Daniela-MC/MALUDA/Captura1.JPG

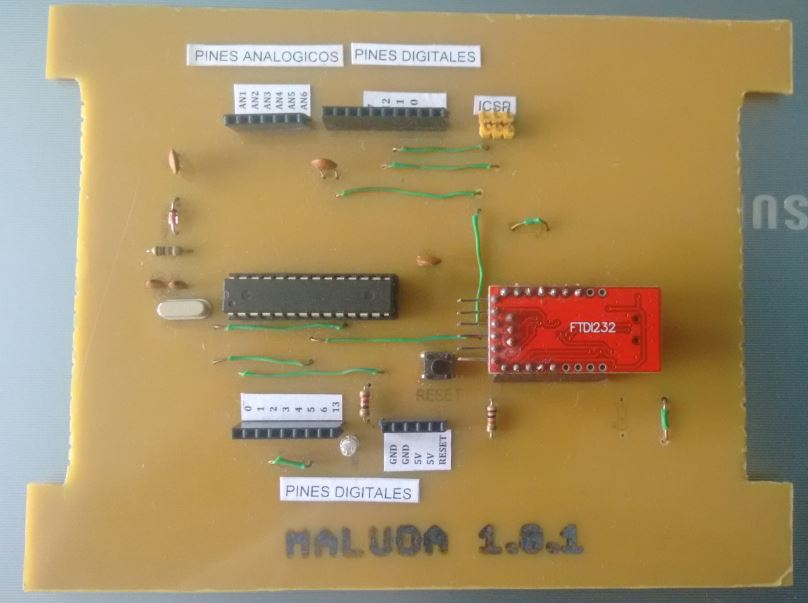
Captura1.JPG
