Daniela-MC/MALUDA/IMG_20170220_080314507.jpg

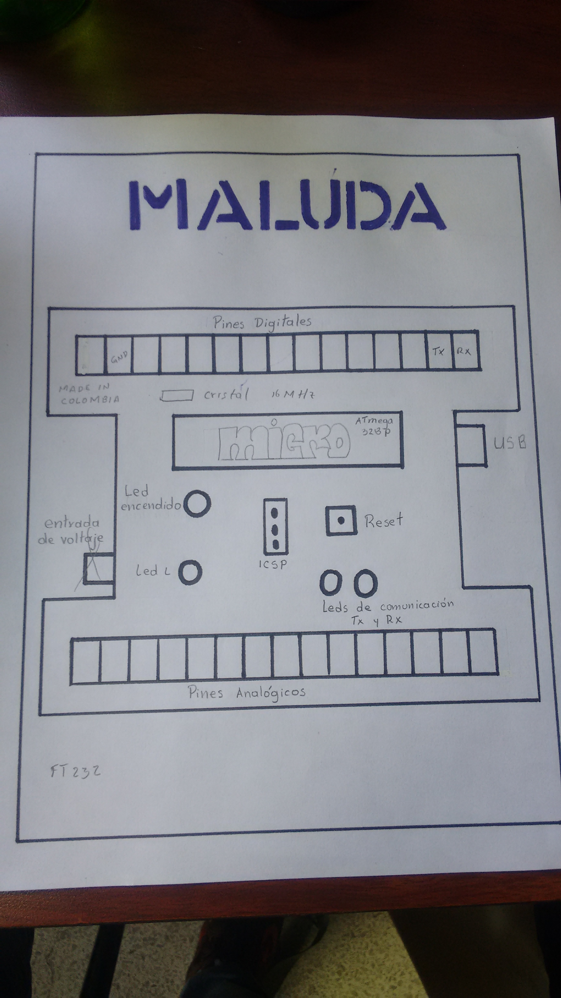
IMG_20170220_080314507.jpg
