Daniela-MC/MALUDA/PCB/PCB.sch

## EAGLE design PCB/PCB.sch (2017-03-07)

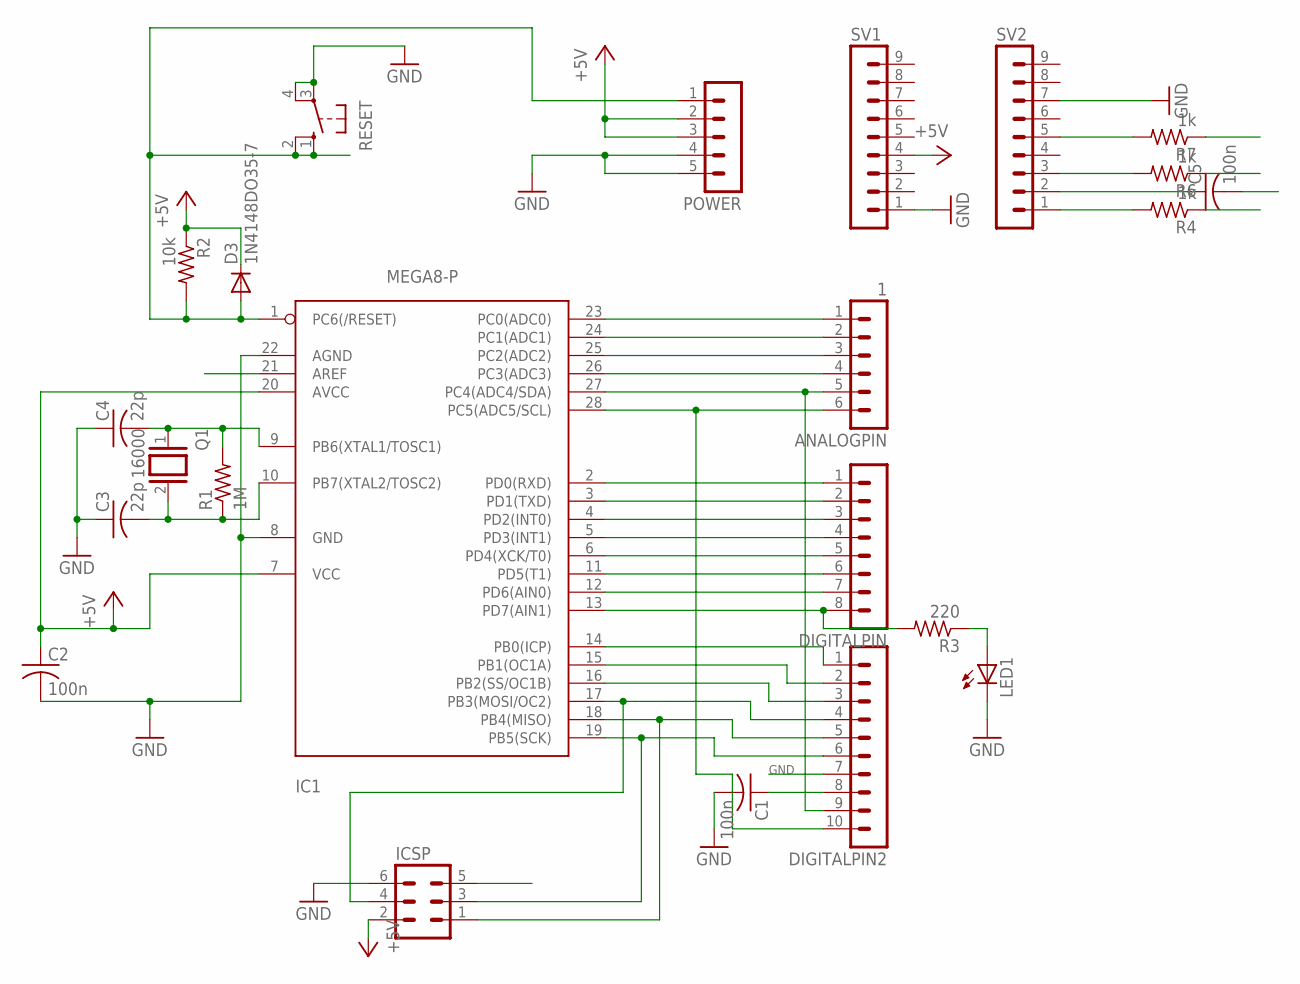
[picture p15: schematic PCB.sch]

Parts:
ANALOGPIN: 1; MA06-1
C1, C2, C5: 100n; C025-024X044
C3, C4: 22p; C025-024X044
D3: 1N4148DO35-7; DO35-7
DIGITALPIN: MA08-1
DIGITALPIN2: MA10-1
IC1: MEGA8-P; DIL28-3
ICSP: MA03-2
LED1: LED3MM
POWER: MA05-1
Q1: 16000; QS
R1: 1M; 0204/7
R2: 10k; 0204/7
R3: 220; 0204/7
R4, R6, R7: 1k; 0204/7
RESET: 10-XX; B3F-10XX
SV1, SV2: MA09-1

Connections:
+5V: C2.1, D3.C, IC1.7 (VCC), IC1.20 (AVCC), ICSP.2, POWER.2, POWER.3, R2.1, SV1.4
AREF: C1.1, DIGITALPIN2.8, IC1.21 (AREF)
GND: C1.2, C2.2, C3.1, C4.1, DIGITALPIN2.7, IC1.8 (GND), IC1.22 (AGND), ICSP.6, LED1.K (C), POWER.4, POWER.5, RESET.3, RESET.4 (P1), SV1.1, SV2.7
unnamed: C4.2, IC1.9 (PB6(XTAL1/TOSC1)), Q1.1, R1.2
unnamed: C3.2, IC1.10 (PB7(XTAL2/TOSC2)), Q1.2, R1.1
unnamed: LED1.A, R3.1
unnamed: C5.1, SV2.2
unnamed: R7.2, SV2.5
unnamed: DIGITALPIN.3, IC1.4 (PD2(INT0))
unnamed: DIGITALPIN.4, IC1.5 (PD3(INT1))
unnamed: DIGITALPIN.5, IC1.6 (PD4(XCK/T0))
unnamed: DIGITALPIN.6, IC1.11 (PD5(T1))
unnamed: DIGITALPIN.7, IC1.12 (PD6(AIN0))
unnamed: DIGITALPIN.8, IC1.13 (PD7(AIN1)), R3.2
unnamed: ANALOGPIN.1, IC1.23 (PC0(ADC0))
unnamed: ANALOGPIN.2, IC1.24 (PC1(ADC1))
unnamed: ANALOGPIN.3, IC1.25 (PC2(ADC2))
unnamed: ANALOGPIN.4, IC1.26 (PC3(ADC3))
unnamed: ANALOGPIN.5, DIGITALPIN2.9, IC1.27 (PC4(ADC4/SDA))
unnamed: R4.2, SV2.1
unnamed: DIGITALPIN2.1, IC1.14 (PB0(ICP))
unnamed: DIGITALPIN2.2, IC1.15 (PB1(OC1A))
unnamed: DIGITALPIN2.3, IC1.16 (PB2(SS/OC1B))
unnamed: DIGITALPIN2.5, IC1.18 (PB4(MISO)), ICSP.1
unnamed: DIGITALPIN2.6, IC1.19 (PB5(SCK)), ICSP.3
unnamed: R6.2, SV2.3
unnamed: DIGITALPIN2.4, IC1.17 (PB3(MOSI/OC2)), ICSP.4
unnamed: ANALOGPIN.6, DIGITALPIN2.10, IC1.28 (PC5(ADC5/SCL))
RES1: C5.2, D3.A, IC1.1 (PC6(/RESET)), ICSP.5, POWER.1, R2.2, R6.1, RESET.1 (S), RESET.2 (S1)
RXD: DIGITALPIN.1, IC1.2 (PD0(RXD)), R4.1
TXD: DIGITALPIN.2, IC1.3 (PD1(TXD)), R7.1
