Daniela-MC/MALUDA/(commit log)

2017-02-24 Se agregó la carpeta avr
2017-02-27 Diseño del PCB
    [PCB.brd, PCB.sch]
2017-03-07 circuito impreso MALUDA
2017-03-07 diseño final del PCB
    [PCB.brd, PCB.sch]
2017-03-13 nueva version cambio de pines
2017-03-31 cambio de las veces que enciende el led
